Genie1992/genie/自制键盘视频相关文件/电路板及电路图/BOM_Editor_keyboard_2020-07-12_22-10-35.csv

ID | Name | Designator | Footprint | Quantity | Manufacturer Part | Manufacturer | Supplier | Supplier Part | LCSC Assembly
1 | MF-MSMF050-2 | U2 | F1812 | 1 | MF-MSMF050-2 | BOURNS | LCSC | C17313
2 | SPI烧录 | U4 | SPI烧录 | 1
3 | Samsung | C1 | C0603 | 1 | 10uF | Samsung Electro-Mechanics | LCSC | C15415
4 | SS14 | D13 | SMA_L4.4-W2.8-LS5.4-RD | 1 | SS14 | MDD | LCSC | C2480 | Yes
5 | 16MHz | X1 | OSC-SMD_3P-L3.2-W1.3-P0.95-L | 1 | CSTCE16M0V53-R0 | MuRata | LCSC | C32180
6 | 10K | R7,R1,R4,R9,R10,R8 | 0603 | 6 | AC0603FR-0715KL | YAGEO | LCSC | C125928
7 | 5.1K | R3,R2 | 0603 | 2 | AC0603FR-0715KL | YAGEO | LCSC | C125928
8 | 22Ω | R5,R6 | 0603 | 2 | AC0603FR-0715KL | YAGEO | LCSC | C125928
9 | 10uF | C3 | CAP-SMD_L3.2-W1.6-R-RD | 1 | TAJA106K006RNJ | AVX | LCSC | C99352 | Yes
10 | ATMEGA32U4 | U3 | SPARKFUN-DIGITALIC_TQFP44 | 1
11 | Button-6x6x8-Right-Angle | SW5 | SW-TH_4PIN_L10.90-W7.70 | 1 | 6*6*8Plastic head,260G, 0.25mm,Side bracket | BBJ | LCSC | C71833
12 | 100nf | C2 | 0603-CAP | 1 | ?
13 | 0.1uf | C4,C5,C6,C10,C9,C8,C7,C11,C12,C13,C14,C17,C16,C18,C15 | 0603-CAP | 15 | ?
14 | 22pf | C20,C19 | 0603-CAP | 2 | ?
15 | AMS1117-5.0 | U1 | SOT-223_L6.5-W3.5-P2.30-LS7.0-BR | 1 | AMS1117-5.0 | AMS | LCSC | C6187 | Yes
16 | TYPE-C-31-M-12 | USBC1 | USB-C_SMD-TYPE-C-31-M-12 | 1 | TYPE-C-31-M-12 | Rectangular Connectors - Contacts | LCSC | C165948
17 | 热插拔3528 | SW6,SW7,SW2,SW3,SW9,SW8,SW11,SW10,SW12,SW13,SW14,SW15,SW1 | 3528热插拔 | 13 | CherryMX
18 | 1N4148W-7-F | D9,D5,D1,D2,D6,D10,D14,D11,D7,D3,D4,D8,D12,D15 | SOD-123_L2.8-W1.8-LS3.7-RD | 14 | 1N4148W-7-F | DIODES | LCSC | C83528 | Yes
19 | AN_zippy | RT1 | AN_ZIPPY | 1 |  |  | ZIPPY
20 | 2.54 4P | JP1 | 4P | 1 | 2.54pitch4PDuPont with lock/ | BOOMELE | LCSC | C41927
21 | EC11E152T409 | SW4 | SW-TH_EC11XXXXXXXX | 1 | EC11E152T409 | ALPS Electric | LCSC | C110314
