Genie1992/genie/自制键盘视频相关文件/3D模型/底盖.stl

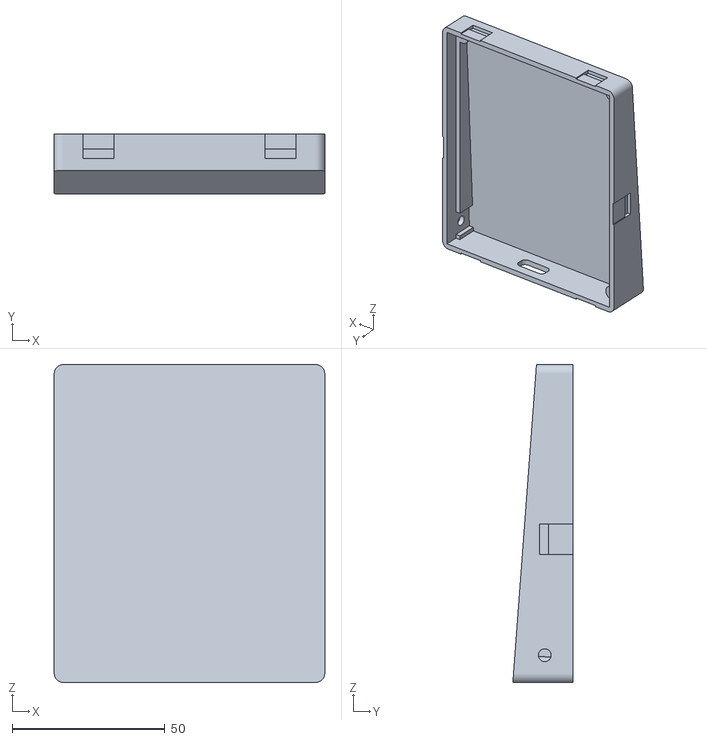
[picture p1: CAD file, 2023-12-28]
自制键盘视频相关文件/3D模型/底盖.stl
88.5 x 19.7 x 104.0
