Genie1992/genie/自制键盘视频相关文件/3D模型/上盖.stl

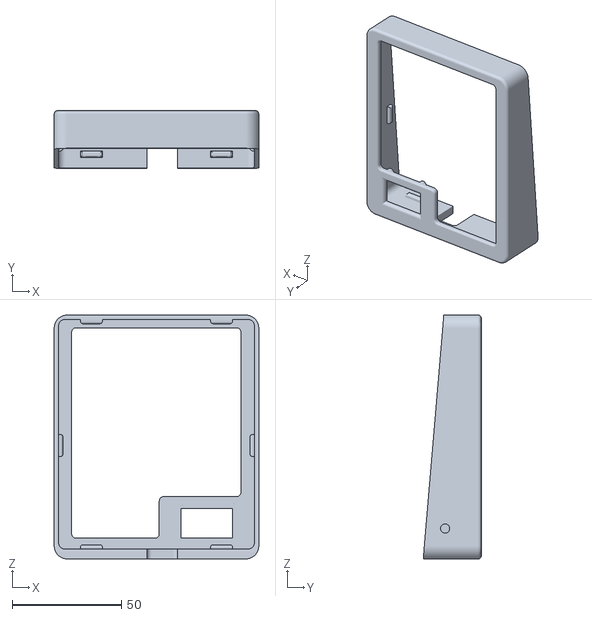
[picture p2: CAD file, 2023-12-28]
自制键盘视频相关文件/3D模型/上盖.stl
93.5 x 26.4 x 111.5
