Genie1992/genie/自制键盘视频相关文件/电路板及电路图/Schematic_Editor_keyboard_2020-07-12_22-10-05.pdf

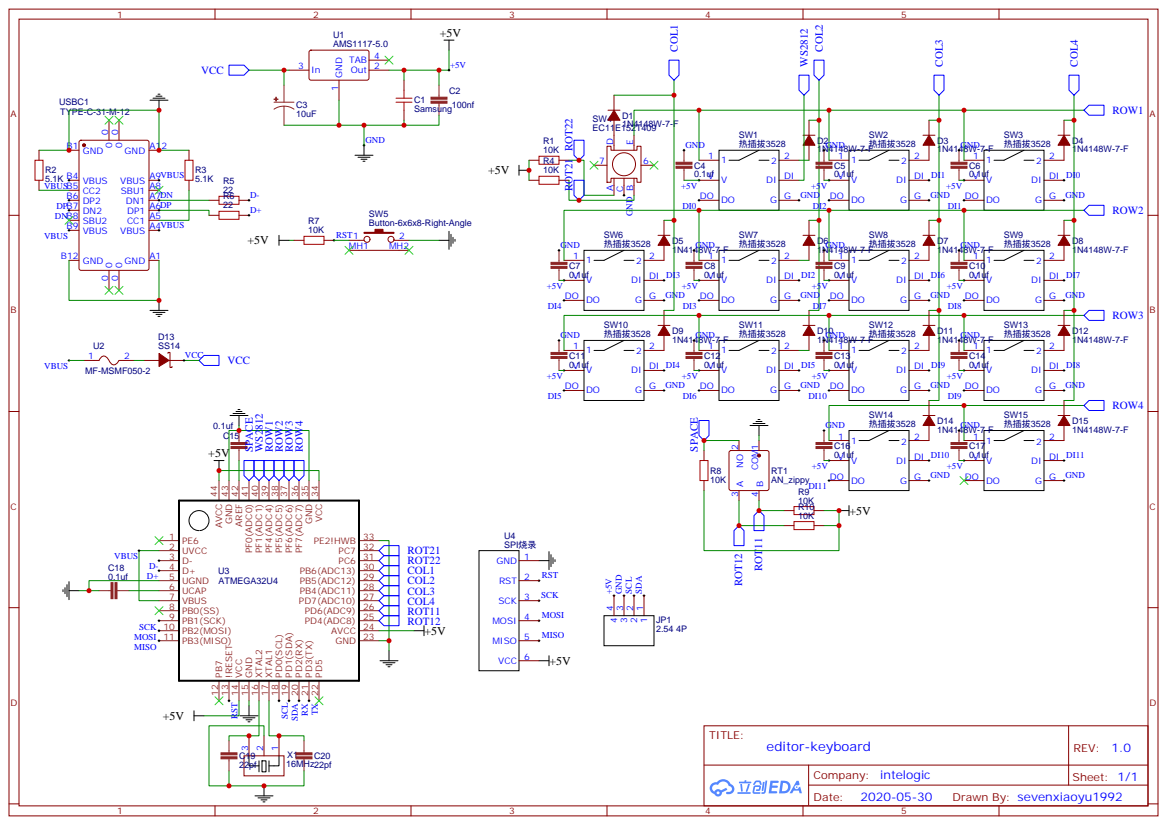
[picture p3: page 1]
