Genie1992/genie/自制键盘视频相关文件/edit_keyboard/config.h

#ifndef CONFIG_H
#define CONFIG_H

#include "config_common.h"

#define space_key F0

/* USB Device descriptor parameter */
#define VENDOR_ID       0xFEED
#define PRODUCT_ID      0x6060
#define DEVICE_VER      0x0001
#define MANUFACTURER    qmkbuilder
#define PRODUCT         keyboard
#define DESCRIPTION     Keyboard

/* key encoders pins*/
#define ENCODERS_PAD_A { C7 , D6 }
#define ENCODERS_PAD_B { C6 , D4 }
#define ENCODER_RESOLUTION 2

/* key matrix size */
#define MATRIX_ROWS 4
#define MATRIX_COLS 4

/* define oled display*/
#define OLED_DISPLAY_128X64
#define OLED_TIMEOUT 100000

/* key matrix pins */
#define MATRIX_ROW_PINS { F4, F5, F6, F7 }
#define MATRIX_COL_PINS { B6, B5, B4, D7 }
#define UNUSED_PINS

/* COL2ROW or ROW2COL */
#define DIODE_DIRECTION ROW2COL

/* number of backlight levels */
//#define BACKLIGHT_PIN B5
//#ifdef BACKLIGHT_PIN
//#define BACKLIGHT_LEVELS 3
//#endif

/* Set 0 if debouncing isn't needed */
#define DEBOUNCING_DELAY 5

/* Mechanical locking support. Use KC_LCAP, KC_LNUM or KC_LSCR instead in keymap */
#define LOCKING_SUPPORT_ENABLE

/* Locking resynchronize hack */
#define LOCKING_RESYNC_ENABLE

/* key combination for command */
#define IS_COMMAND() ( \
    keyboard_report->mods == (MOD_BIT(KC_LSHIFT) | MOD_BIT(KC_RSHIFT)) \
)

/* prevent stuck modifiers */
#define PREVENT_STUCK_MODIFIERS


#define RGB_DI_PIN F1
#ifdef RGB_DI_PIN
#define RGBLIGHT_ANIMATIONS
#define RGBLED_NUM 13
#define RGBLIGHT_HUE_STEP 8
#define RGBLIGHT_SAT_STEP 8
#define RGBLIGHT_VAL_STEP 8
#endif

#endif
